little-red-rover/little-red-rover/README.md

# Little Red Rover

The Little Red Rover project has moved! Its new home is the [Little Red Rover GitHub organization](https://github.com/little-red-rover).
