little-red-rover/little-red-rover/HARDWARE/README.md

# HARDWARE

<p align="center">
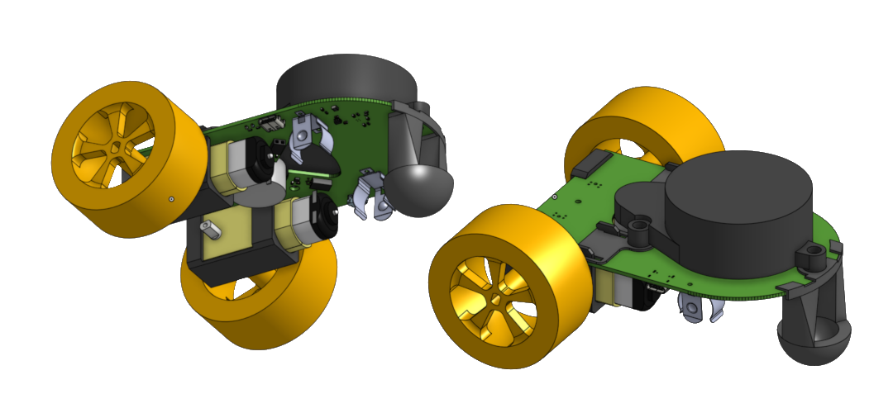
[picture p1: HARDWARE/assets/lrr_hardware_splash.png]
Splash image of LRR CAD
  
</p>

Little red rover was designed using OnShape and KiCAD (
[OnShape project](https://cad.onshape.com/documents/3c9bcb798eb55dc89c3300c0/w/50990f614f9cfbc3dc016690/e/81981a5257c68cf876fffafa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), [KiCAD project](https://github.com/usedhondacivic/little_red_rover/tree/main/HARDWARE/little_red_rover)
).

It is composed of:

* one PCB body
* five 3D printed components (one front skid, two motor mounts, two shims)
* two [TT motors](https://www.adafruit.com/product/3777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)
* two [wheels](https://www.adafruit.com/product/3766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)
* one [LD20 LiDAR](https://www.youyeetoo.com/products/youyeetoo-fhl-ld20)
* three M3 screws

and thats it!
