little-red-rover/little-red-rover/HARDWARE/assets/back_glam.jpg

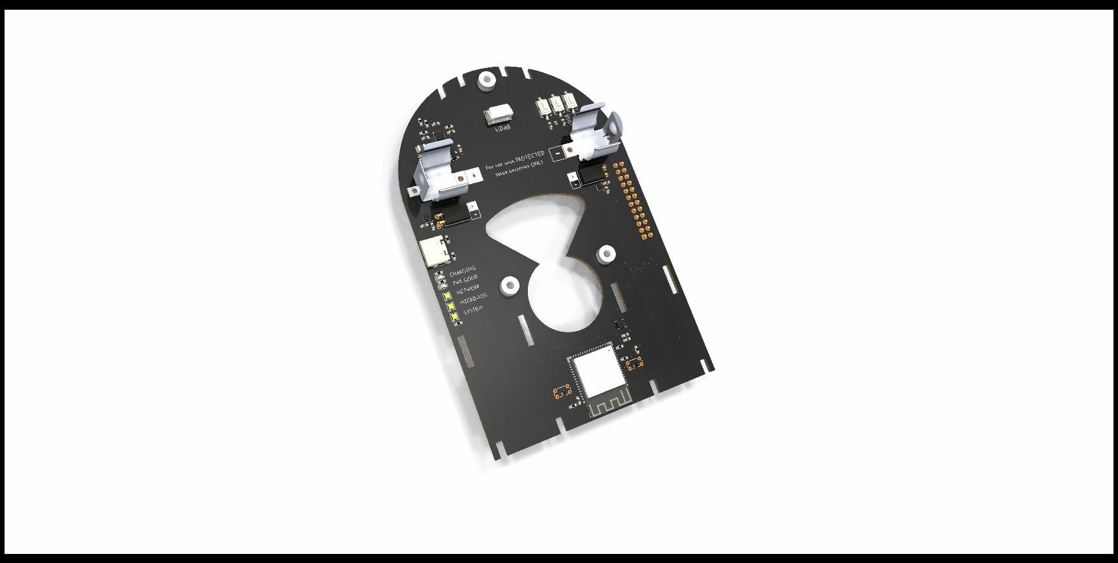
HARDWARE/assets/back_glam.jpg
