little-red-rover/little-red-rover/HARDWARE/assets/lrr_cad_bottom.png

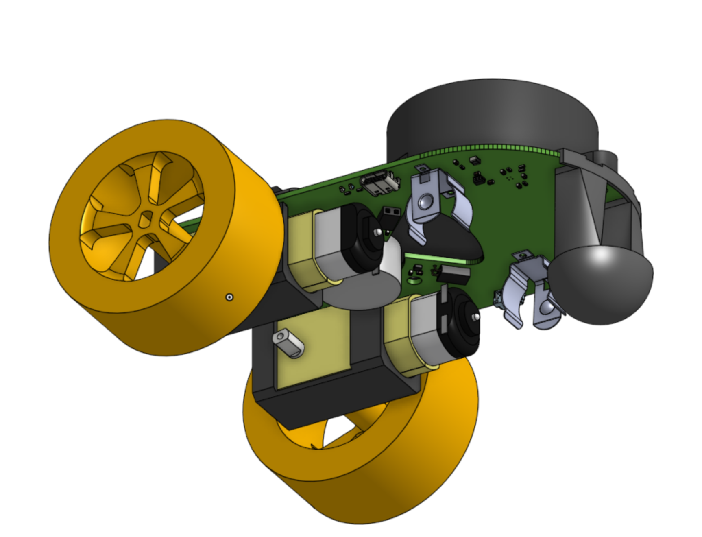
HARDWARE/assets/lrr_cad_bottom.png
