little-red-rover/little-red-rover/HARDWARE/assets/lrr_cad_top.png

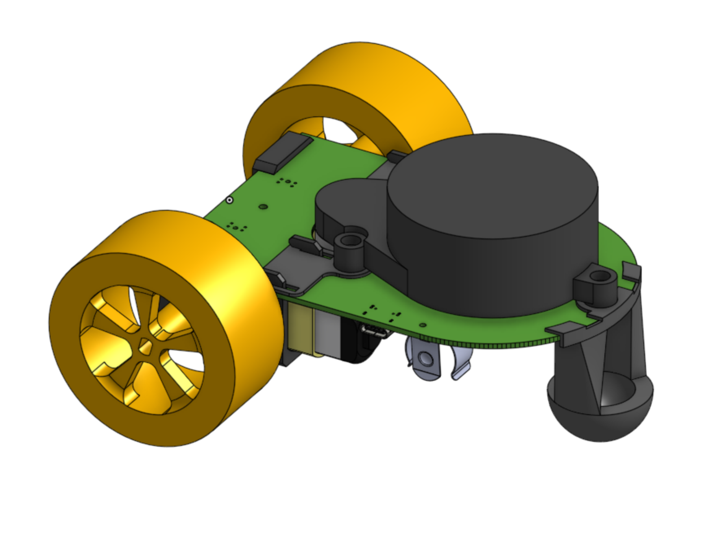
HARDWARE/assets/lrr_cad_top.png
