little-red-rover/little-red-rover/HARDWARE/assets/lrr_ecad.png

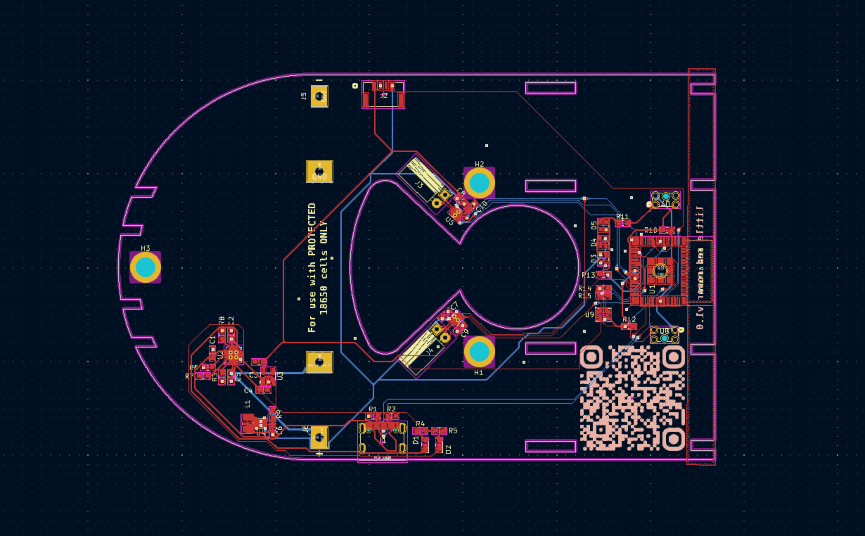
HARDWARE/assets/lrr_ecad.png
