little-red-rover/little-red-rover/SOFTWARE/ros2_ws/src/little_red_rover/description/rover/robot_body_visual.stl

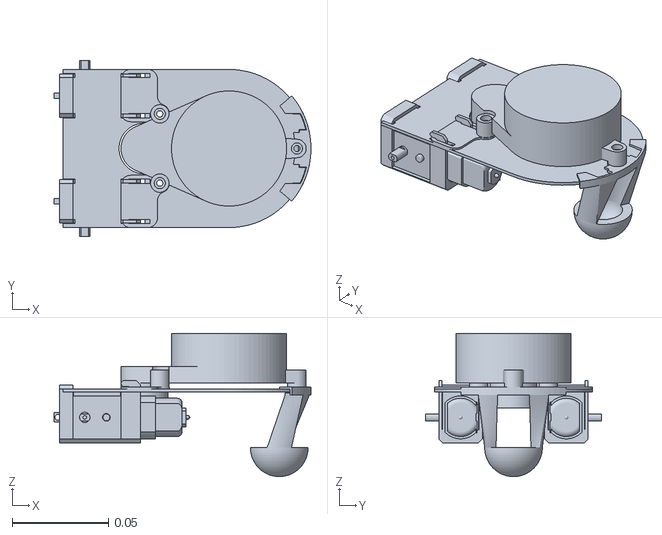
[picture p7: CAD file, 2024-08-25]
SOFTWARE/ros2_ws/src/little_red_rover/description/rover/robot_body_visual.stl
0.134 x 0.0916 x 0.0744
