little-red-rover/little-red-rover/SOFTWARE/ros2_ws/src/little_red_rover/description/rover/wheel_right_visual.stl

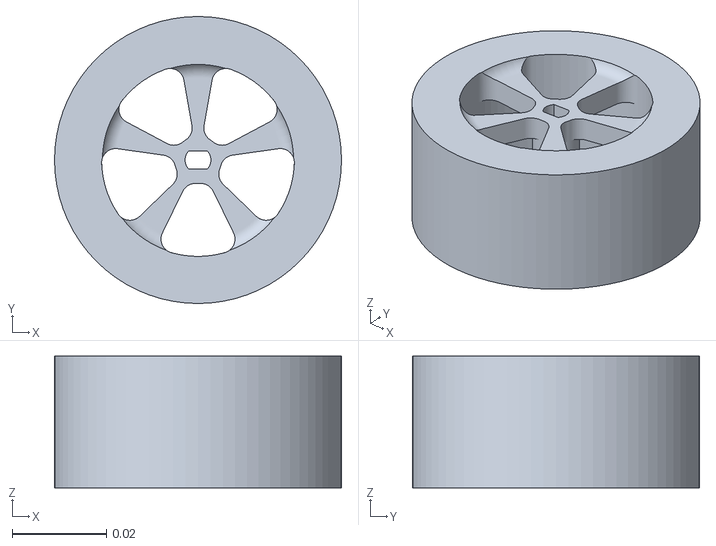
[picture p8: CAD file, 2024-08-25]
SOFTWARE/ros2_ws/src/little_red_rover/description/rover/wheel_right_visual.stl
0.061 x 0.061 x 0.0279
