little-red-rover/little-red-rover/SOFTWARE/ros2_ws/src/little_red_rover/description/rover/tt_motor_mount.stl

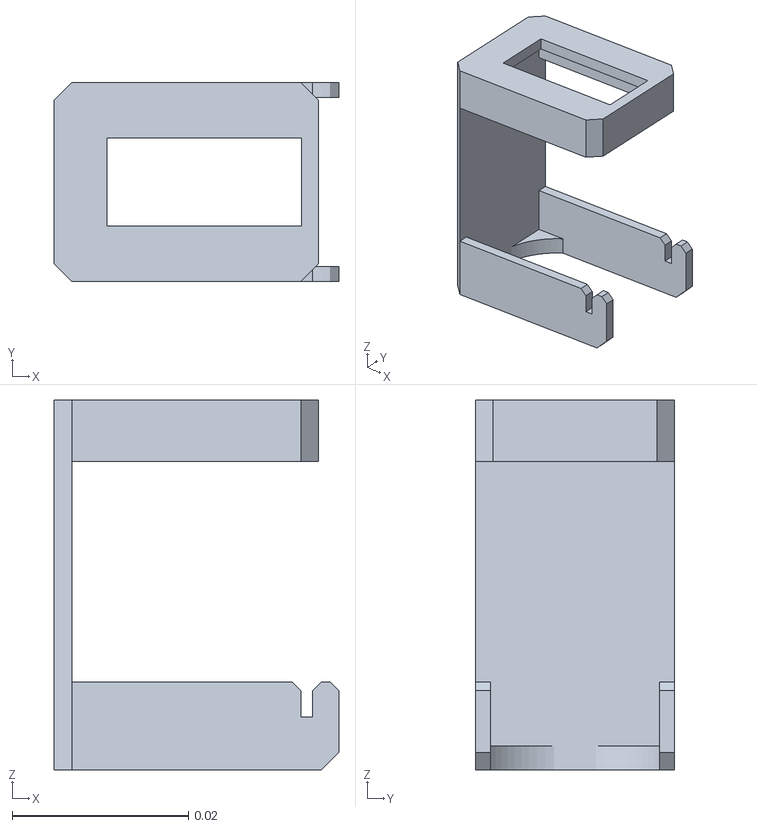
[picture p9: CAD file, 2024-08-04]
SOFTWARE/ros2_ws/src/little_red_rover/description/rover/tt_motor_mount.stl
0.0323 x 0.0226 x 0.042
