little-red-rover/little-red-rover/SOFTWARE/ros2_ws/src/little_red_rover/description/rover/motor_mount_shim.stl

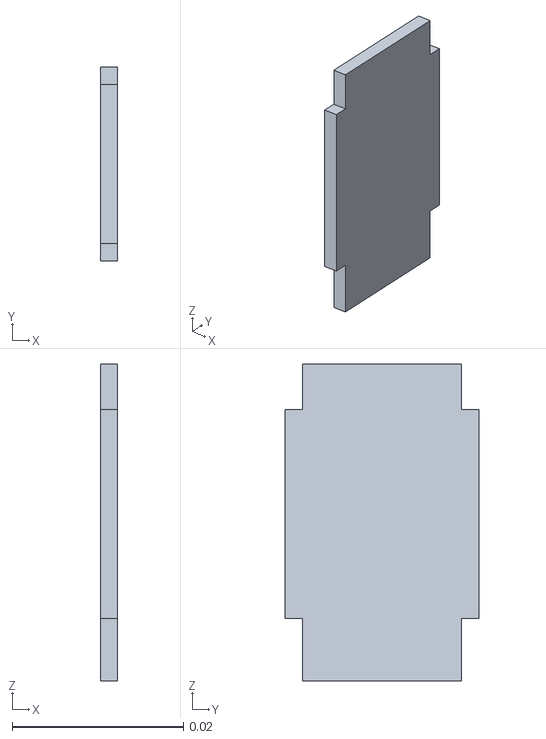
[picture p10: CAD file, 2024-08-04]
SOFTWARE/ros2_ws/src/little_red_rover/description/rover/motor_mount_shim.stl
0.002 x 0.0226 x 0.037
