little-red-rover/little-red-rover/SOFTWARE/ros2_ws/src/little_red_rover/description/rover/lidar_top.stl

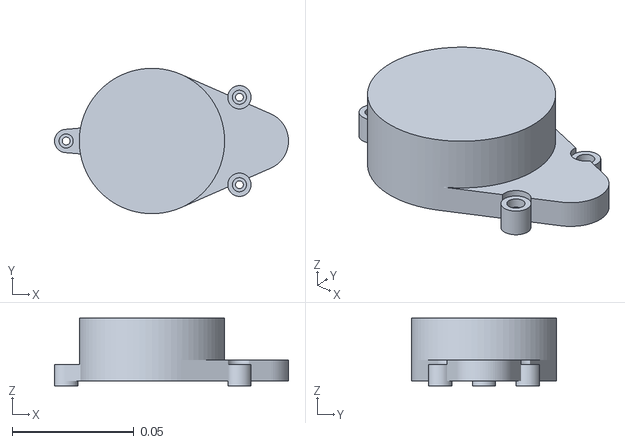
[picture p11: CAD file, 2024-08-04]
SOFTWARE/ros2_ws/src/little_red_rover/description/rover/lidar_top.stl
0.0963 x 0.0598 x 0.0279
