little-red-rover/little-red-rover/SOFTWARE/ros2_ws/src/little_red_rover/description/rover/motor_attachment_shim.stl

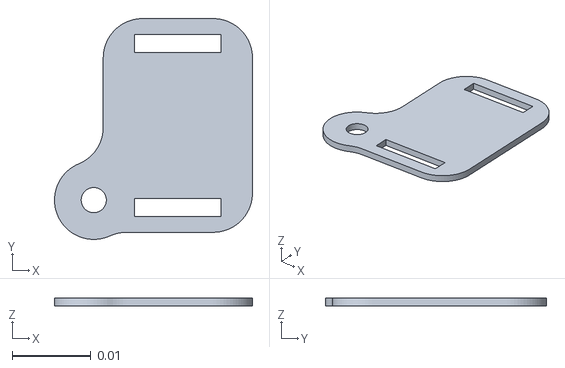
[picture p12: CAD file, 2024-08-04]
SOFTWARE/ros2_ws/src/little_red_rover/description/rover/motor_attachment_shim.stl
0.0252 x 0.0281 x 0.001
