little-red-rover/little-red-rover/SOFTWARE/ros2_ws/src/little_red_rover/description/rover/pcb.stl

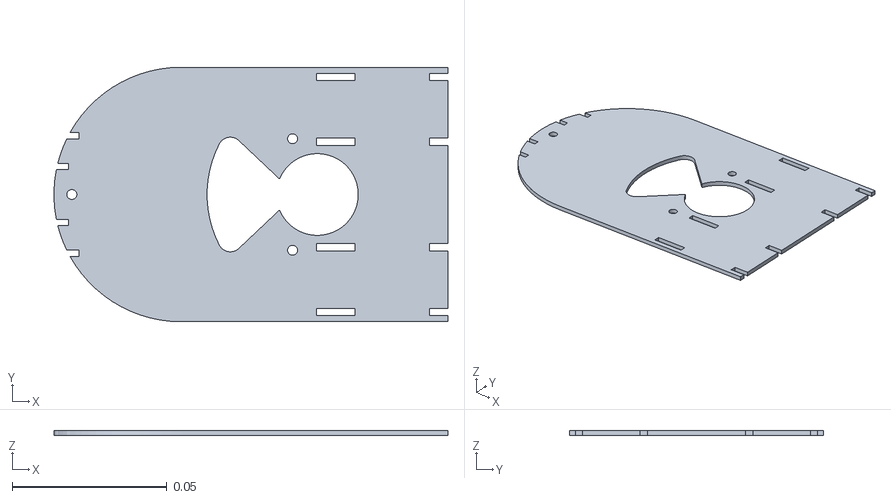
[picture p13: CAD file, 2024-08-04]
SOFTWARE/ros2_ws/src/little_red_rover/description/rover/pcb.stl
0.127 x 0.0822 x 0.0016
