little-red-rover/little-red-rover/SOFTWARE/ros2_ws/src/little_red_rover/description/rover/skid.stl

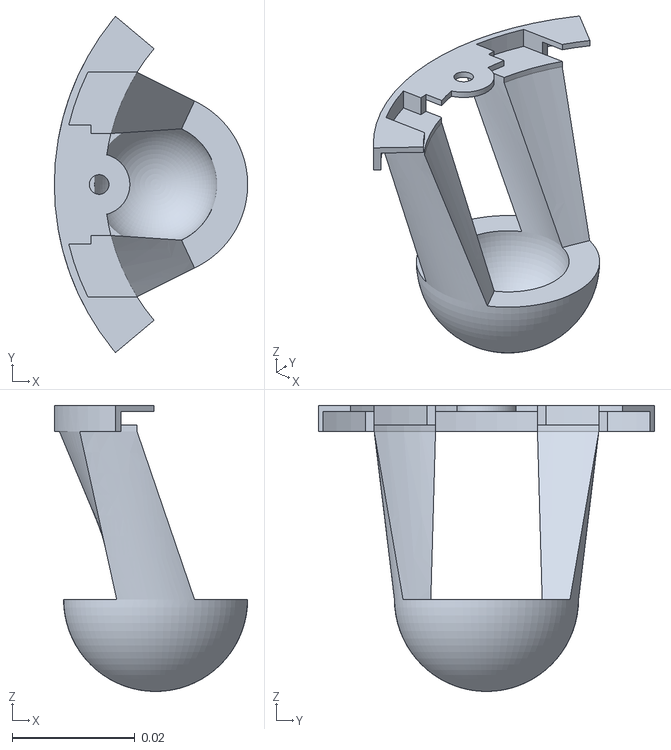
[picture p14: CAD file, 2024-08-04]
SOFTWARE/ros2_ws/src/little_red_rover/description/rover/skid.stl
0.0315 x 0.0548 x 0.0466
