little-red-rover/little-red-rover/SOFTWARE/ros2_ws/src/little_red_rover/description/rover/lidar_motor.stl

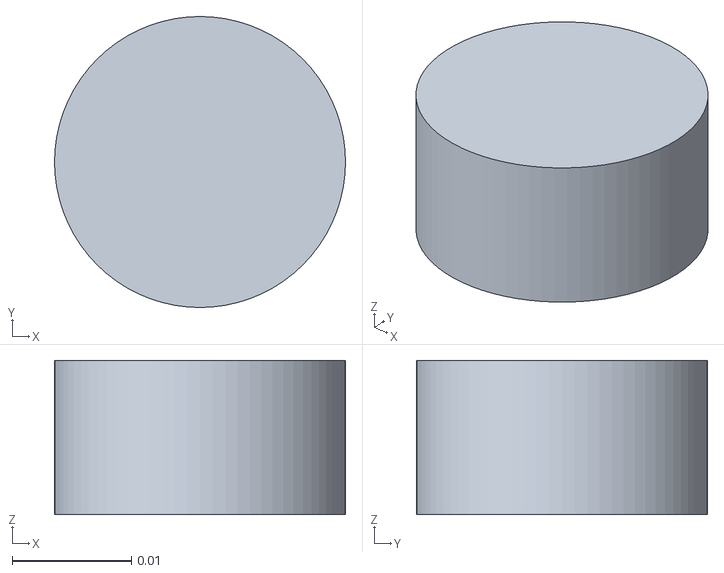
[picture p15: CAD file, 2024-08-04]
SOFTWARE/ros2_ws/src/little_red_rover/description/rover/lidar_motor.stl
0.0244 x 0.0244 x 0.0129
