little-red-rover/little-red-rover/SOFTWARE/ros2_ws/src/little_red_rover/description/rover/coordinate_frame.stl

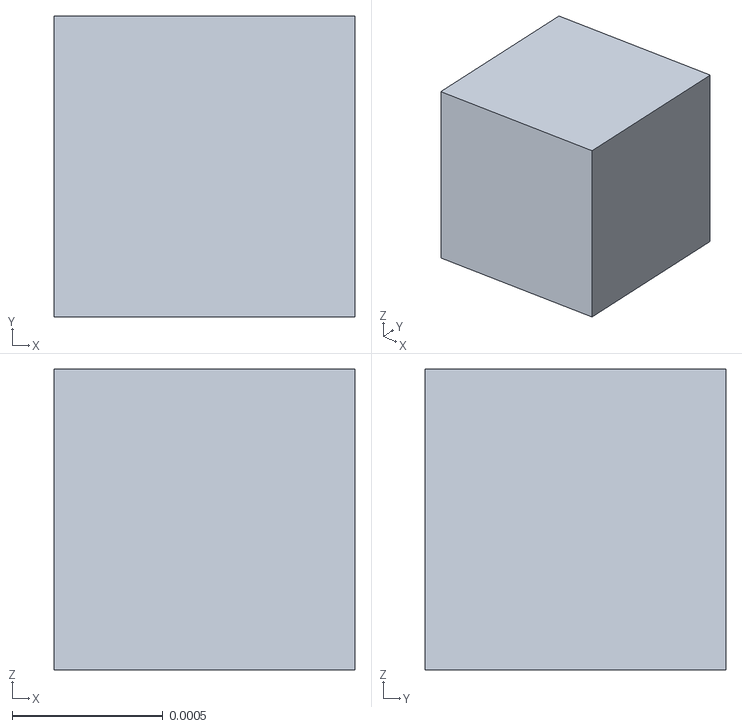
[picture p16: CAD file, 2024-07-20]
SOFTWARE/ros2_ws/src/little_red_rover/description/rover/coordinate_frame.stl
0.001 x 0.001 x 0.001
