little-red-rover/little-red-rover/SOFTWARE/ros2_ws/src/little_red_rover/description/rover/encoder_ring.stl

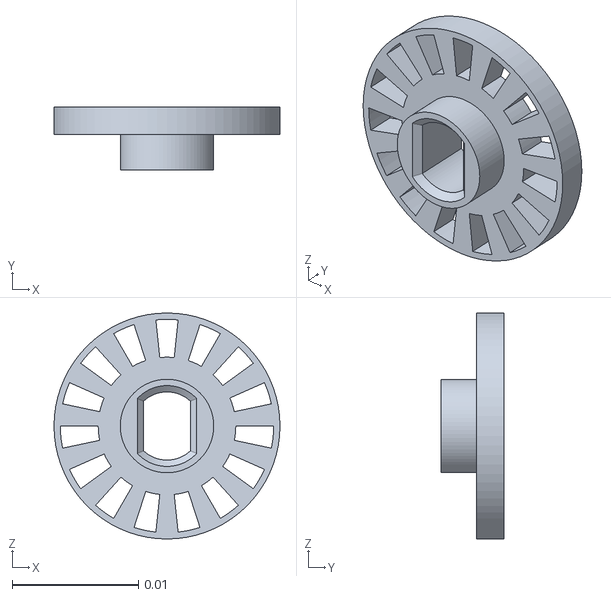
[picture p17: CAD file, 2024-07-16]
SOFTWARE/ros2_ws/src/little_red_rover/description/rover/encoder_ring.stl
0.0179 x 0.005 x 0.0179
