little-red-rover/little-red-rover/SOFTWARE/ros2_ws/src/little_red_rover/description/rover/tt_motor_mount_right.stl

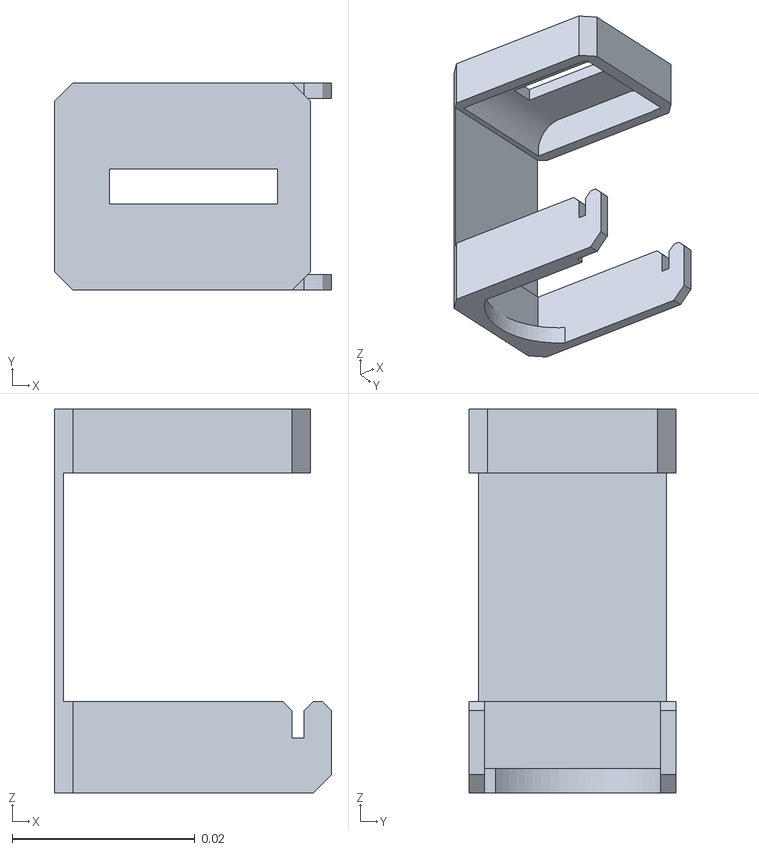
[picture p18: CAD file, 2024-05-02]
SOFTWARE/ros2_ws/src/little_red_rover/description/rover/tt_motor_mount_right.stl
0.0303 x 0.0226 x 0.042
