little-red-rover/little-red-rover/SOFTWARE/ros2_ws/src/little_red_rover/description/rover/tt_motor_3777_v10.stl

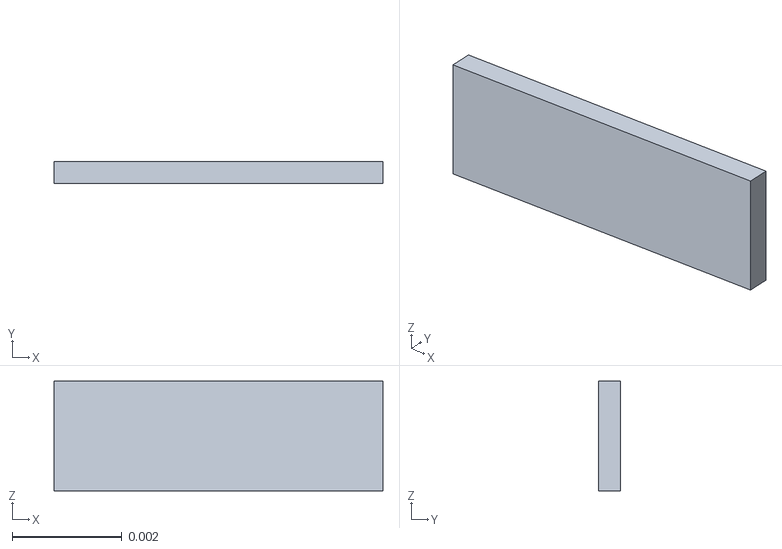
[picture p19: CAD file, 2024-05-02]
SOFTWARE/ros2_ws/src/little_red_rover/description/rover/tt_motor_3777_v10.stl
0.006 x 0.0004 x 0.002
