little-red-rover/little-red-rover/(list of files, cad)

Other CAD files:
SOFTWARE/ros2_ws/src/little_red_rover/description/rover/wheel_left_visual.stl
SOFTWARE/ros2_ws/src/little_red_rover/description/rover/wheel_right.stl
SOFTWARE/ros2_ws/src/little_red_rover/description/rover/wheel_2_visual.stl
SOFTWARE/ros2_ws/src/little_red_rover/description/rover/wheel_visual.stl
SOFTWARE/ros2_ws/src/little_red_rover/description/rover/wheel_left.stl
SOFTWARE/ros2_ws/src/little_red_rover/description/rover/tt_motor_mount_left.stl
SOFTWARE/ros2_ws/src/little_red_rover/description/rover/wheel.stl
