little-red-rover/little-red-rover/HARDWARE/little_red_rover/little_red_rover.kicad_pcb

## KiCad design HARDWARE/little_red_rover/little_red_rover.kicad_pcb (2024-06-24)

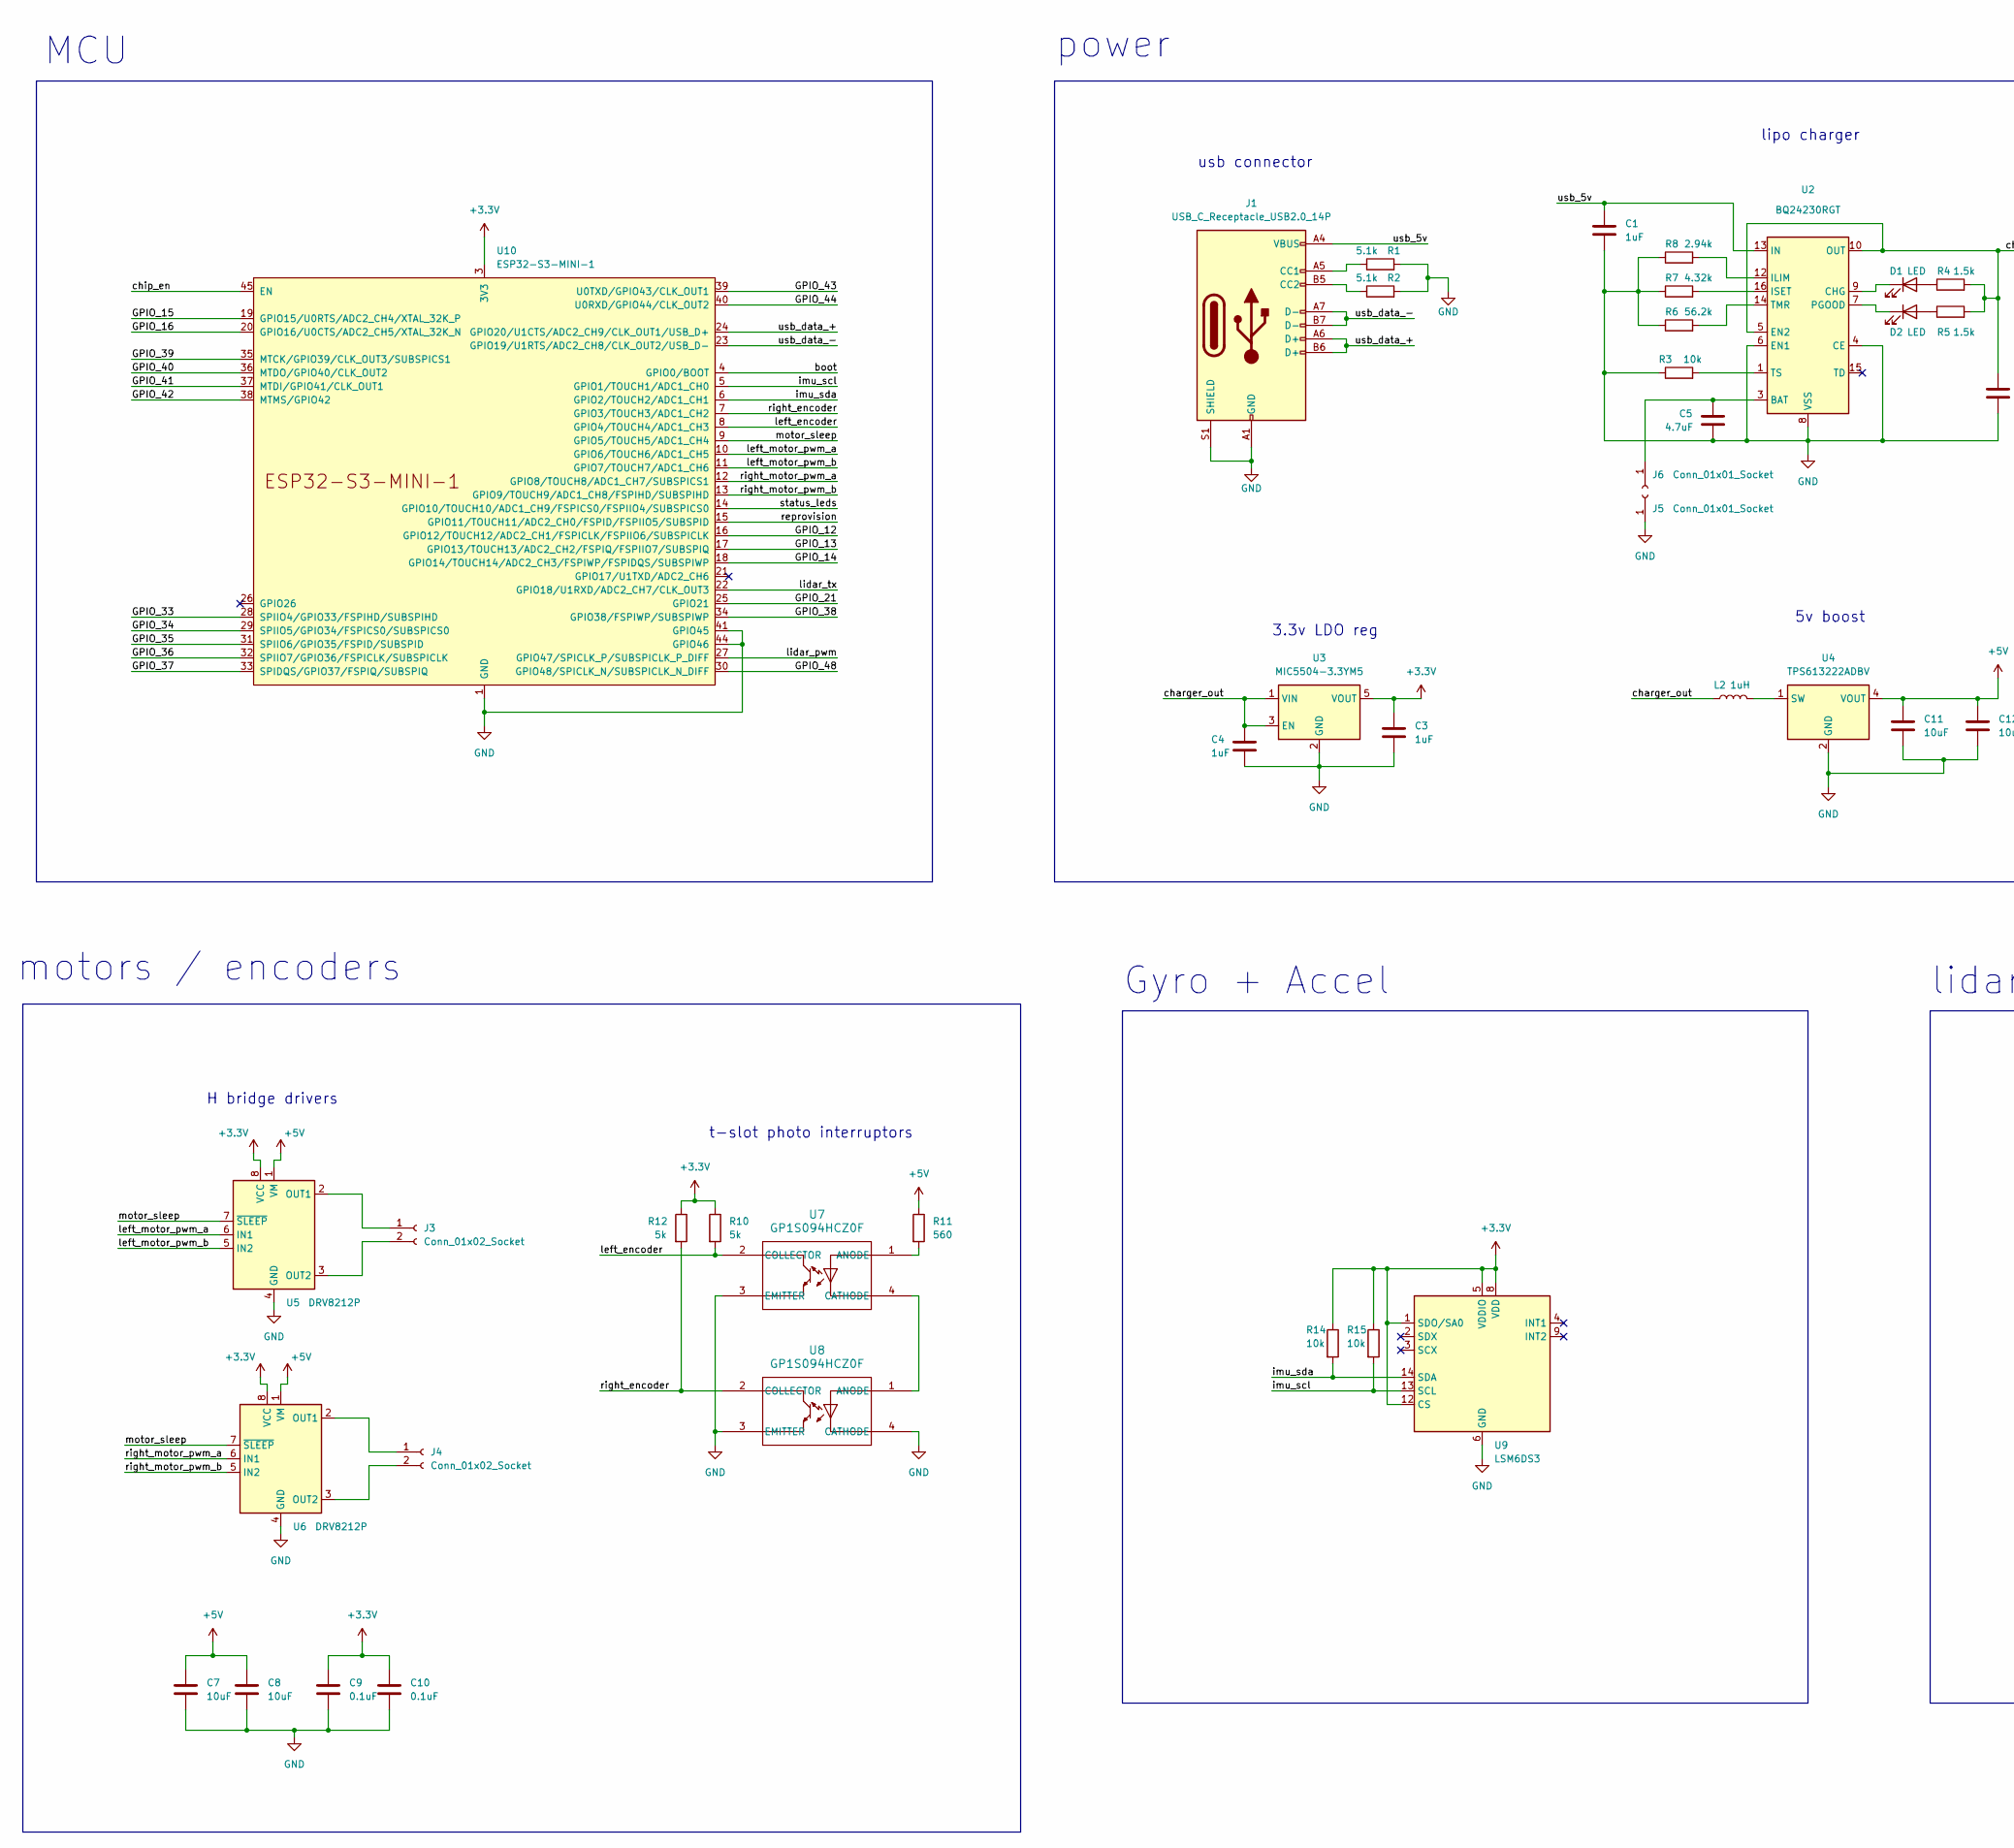
[picture p20: schematic little_red_rover.kicad_sch, Little Red Rover, part in row 1, column 1]

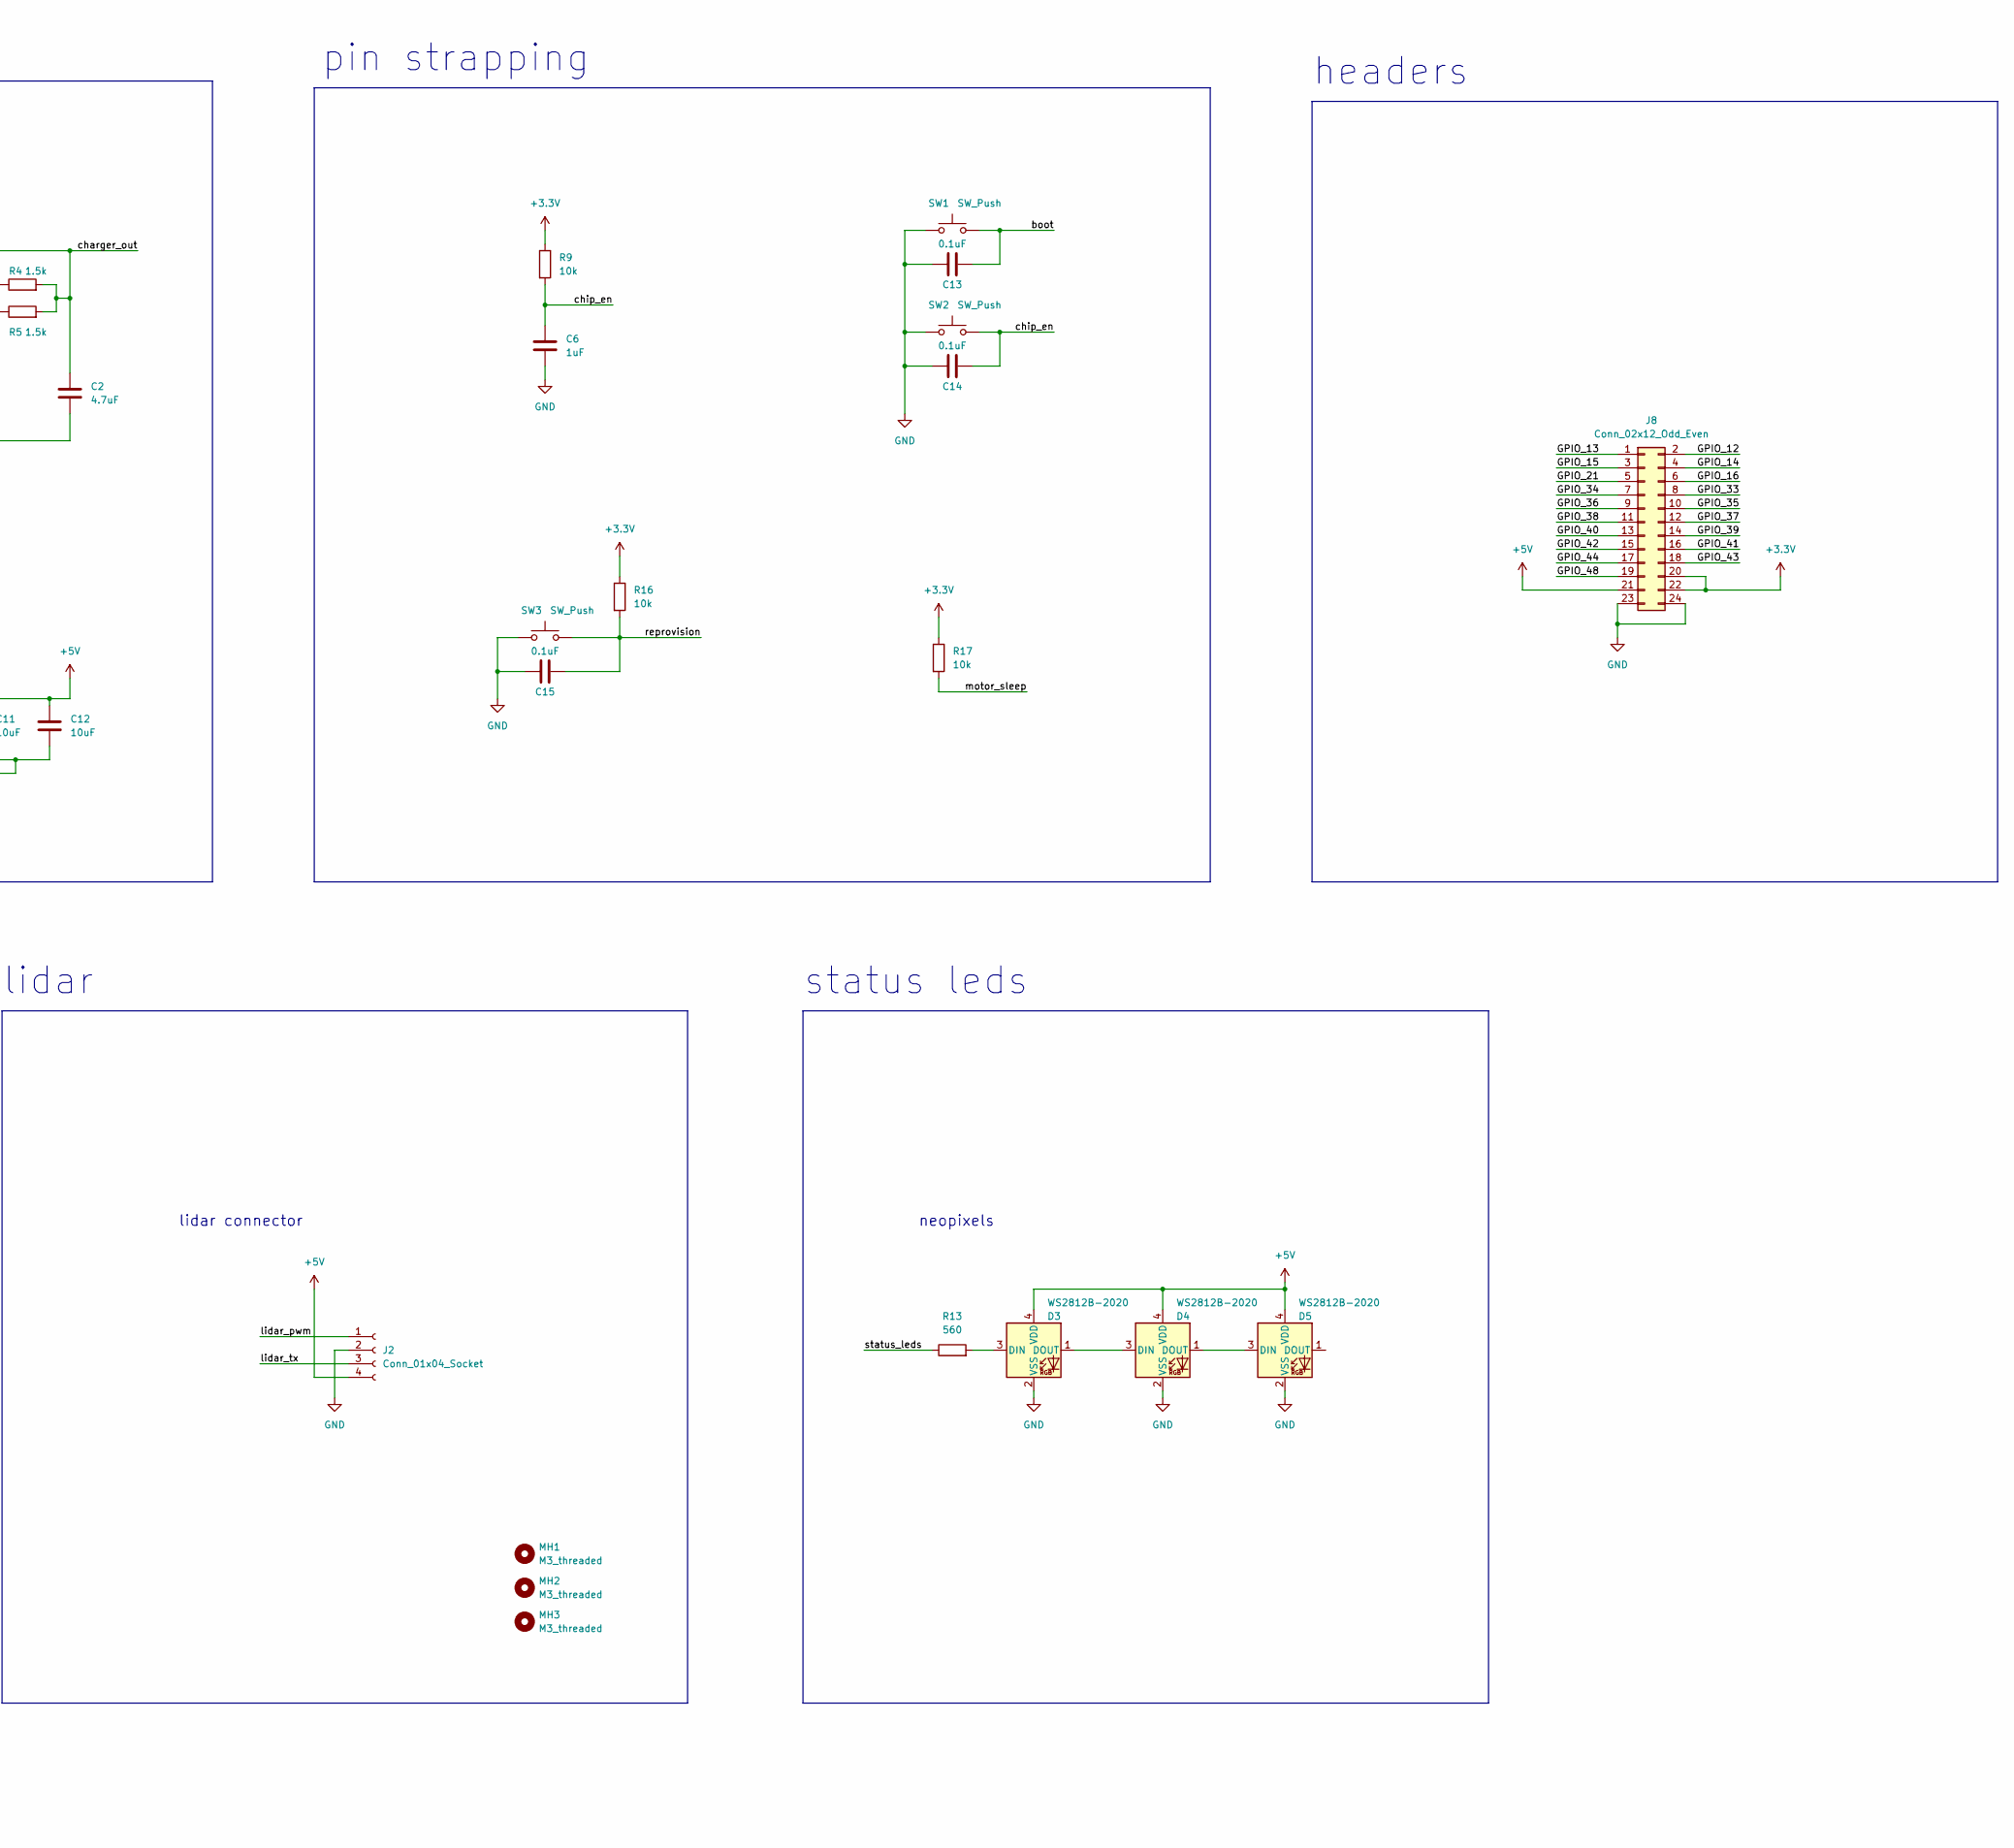
[picture p21: schematic little_red_rover.kicad_sch, Little Red Rover, part in row 1, column 2]

Parts:
C1, C3, C4: 1uF; C_0603_1608Metric_Pad1.08x0.95mm_HandSolder; JLC 0603
C2, C5: 4.7uF; C_0603_1608Metric_Pad1.08x0.95mm_HandSolder; JLC 0603
C6: 1uF; C_0603_1608Metric_Pad1.08x0.95mm_HandSolder
C7, C8, C11, C12: 10uF; C_0603_1608Metric_Pad1.08x0.95mm_HandSolder; JLC 0603
C9, C10: 0.1uF; C_0603_1608Metric_Pad1.08x0.95mm_HandSolder; JLC 0603
C13, C14, C15: 0.1uF; C_0603_1608Metric_Pad1.08x0.95mm_HandSolder
D1, D2: LED; LED_0603_1608Metric_Pad1.05x0.95mm_HandSolder; JLC 0603
D3, D4, D5: WS2812B-2020; LED_WS2812B-2020_PLCC4_2.0x2.0mm; JLC SMD,2x2mm
J1: USB_C_Receptacle_USB2.0_14P; USB_C_Receptacle_GCT_USB4105-xx-A_16P_TopMnt_Horizontal; JLC SMD
J2: Conn_01x04_Socket; CONN_SM04B-GHS-TB_JST; JLC SMD,P=1.25mm
J3, J4: Conn_01x02_Socket; PinSocket_1x02_P2.54mm_Horizontal; JLC Push-Pull,P=2.54mm
J5, J6: Conn_01x01_Socket; 18650_holder; JLC SMD
J8: Conn_02x12_Odd_Even; PinHeader_2x12_P2.54mm_Vertical
L2: 1uH; L_1008_2520Metric_Pad1.43x2.20mm_HandSolder; JLC 1008
MH1, MH2, MH3: M3_threaded; m3_threaded_insert; LCSC C5301780
R1, R2: 5.1k; R_0603_1608Metric_Pad0.98x0.95mm_HandSolder; JLC 0603
R3: 10k; R_0603_1608Metric_Pad0.98x0.95mm_HandSolder; JLC 0603
R4, R5: 1.5k; R_0603_1608Metric_Pad0.98x0.95mm_HandSolder; JLC 0603
R6: 56.2k; R_0603_1608Metric_Pad0.98x0.95mm_HandSolder; JLC 0603
R7: 4.32k; R_0603_1608Metric_Pad0.98x0.95mm_HandSolder; JLC 0603
R8: 2.94k; R_0603_1608Metric_Pad0.98x0.95mm_HandSolder; JLC 0603
R9, R16, R17: 10k; R_0603_1608Metric_Pad0.98x0.95mm_HandSolder
R10, R12: 5k; R_0603_1608Metric_Pad0.98x0.95mm_HandSolder; JLC 0603
R11, R13: 560; R_0603_1608Metric_Pad0.98x0.95mm_HandSolder; JLC 0603
R14, R15: 10k; C_0603_1608Metric_Pad1.08x0.95mm_HandSolder; JLC 0603
SW1, SW2, SW3: SW_Push; SW_Tactile_SPST_NO_Straight_CK_PTS636Sx25SMTRLFS
U2: BQ24230RGT; VQFN-16-1EP_3x3mm_P0.5mm_EP1.68x1.68mm_ThermalVias; JLC VQFN-16-EP(3x3)
U3: MIC5504-3.3YM5; SOT-23-5; JLC SOT-23-5
U4: TPS613222ADBV; SOT-23-5; JLC SOT-23-5
U5, U6: DRV8212P; WSON-8-1EP_2x2mm_P0.5mm_EP0.9x1.6mm_ThermalVias; JLC WSON-8(2x2)
U7, U8: GP1S094HCZ0F; TO_4HCZ0F_SHP; JLC DIP-4
U9: LSM6DS3; LGA-14_3x2.5mm_P0.5mm_LayoutBorder3x4y; JLC LGA-14(2.5x3)
U10: ESP32-S3-MINI-1; ESP32-S2-MINI-1_HandSoldering

Connections:
+3.3V: C3.1, C9.1, C10.1, J8.20, J8.22, R9.1, R10.1, R12.1, R14.1, R15.1, R16.1, R17.1, U3.5 (VOUT), U5.8 (VCC), U6.8 (VCC), U9.1 (SDO/SA0), U9.5 (VDDIO), U9.8 (VDD), U9.12 (CS), U10.3 (3V3)
+5V: C7.1, C8.1, C11.1, C12.1, D3.4 (VDD), D4.4 (VDD), D5.4 (VDD), J2.4, J8.21, R11.1, U4.4 (VOUT), U5.1 (VM), U6.1 (VM)
/GPIO_12: J8.2, U10.16 (GPIO12/TOUCH12/ADC2_CH1/FSPICLK/FSPIIO6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)
/GPIO_13: J8.1, U10.17 (GPIO13/TOUCH13/ADC2_CH2/FSPIQ/FSPIIO7/S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)
/GPIO_14: J8.4, U10.18 (GPIO14/TOUCH14/ADC2_CH3/FSPIWP/FSPIDQS/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)
/GPIO_15: J8.3, U10.19 (GPIO15/U0RTS/ADC2_CH4/XTAL_32K_P)
/GPIO_16: J8.6, U10.20 (GPIO16/U0CTS/ADC2_CH5/XTAL_32K_N)
/GPIO_21: J8.5, U10.25 (GPIO21)
/GPIO_33: J8.8, U10.28 (SPIIO4/GPIO33/FSPIHD/SUBSPIHD)
/GPIO_34: J8.7, U10.29 (SPIIO5/GPIO34/FSPICS0/SUBSPICS0)
/GPIO_35: J8.10, U10.31 (SPIIO6/GPIO35/FSPID/SUBSPID)
/GPIO_36: J8.9, U10.32 (SPIIO7/GPIO36/FSPICLK/SUBSPICLK)
/GPIO_37: J8.12, U10.33 (SPIDQS/GPIO37/FSPIQ/SUBSPIQ)
/GPIO_38: J8.11, U10.34 (GPIO38/FSPIWP/SUBSPIWP)
/GPIO_39: J8.14, U10.35 (MTCK/GPIO39/CLK_OUT3/SUBSPICS1)
/GPIO_40: J8.13, U10.36 (MTDO/GPIO40/CLK_OUT2)
/GPIO_41: J8.16, U10.37 (MTDI/GPIO41/CLK_OUT1)
/GPIO_42: J8.15, U10.38 (MTMS/GPIO42)
/GPIO_43: J8.18, U10.39 (U0TXD/GPIO43/CLK_OUT1)
/GPIO_44: J8.17, U10.40 (U0RXD/GPIO44/CLK_OUT2)
/GPIO_48: J8.19, U10.30 (GPIO48/SPICLK_N/SUBSPICLK_N_DIFF)
/boot: C13.2, SW1.2, U10.4 (GPIO0/BOOT)
/charger_out: C2.1, C4.1, L2.1, R4.2, R5.2, U2.5 (EN2), U2.10 (OUT), U2.11 (OUT), U3.1 (VIN), U3.3 (EN)
/chip_en: C6.1, C14.2, R9.2, SW2.2, U10.45 (EN)
/imu_scl: R15.2, U9.13 (SCL), U10.5 (GPIO1/TOUCH1/ADC1_CH0)
/imu_sda: R14.2, U9.14 (SDA), U10.6 (GPIO2/TOUCH2/ADC1_CH1)
/left_encoder: R10.2, U7.2 (COLLECTOR), U10.8 (GPIO4/TOUCH4/ADC1_CH3)
/left_motor_pwm_a: U5.6 (IN1), U10.10 (GPIO6/TOUCH6/ADC1_CH5)
/left_motor_pwm_b: U5.5 (IN2), U10.11 (GPIO7/TOUCH7/ADC1_CH6)
/lidar_pwm: J2.1, U10.27 (GPIO47/SPICLK_P/SUBSPICLK_P_DIFF)
/lidar_tx: J2.3, U10.22 (GPIO18/U1RXD/ADC2_CH7/CLK_OUT3)
/motor_sleep: R17.2, U5.7 (~SLEEP), U6.7 (~SLEEP), U10.9 (GPIO5/TOUCH5/ADC1_CH4)
/reprovision: C15.2, R16.2, SW3.2, U10.15 (GPIO11/TOUCH11/ADC2_CH0/FSPID/FSPIIO5/S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)
/right_encoder: R12.2, U8.2 (COLLECTOR), U10.7 (GPIO3/TOUCH3/ADC1_CH2)
/right_motor_pwm_a: U6.6 (IN1), U10.12 (GPIO8/TOUCH8/ADC1_CH7/SUBSPICS1)
/right_motor_pwm_b: U6.5 (IN2), U10.13 (GPIO9/TOUCH9/ADC1_CH8/FSPIHD/SUBSPIHD)
/status_leds: R13.1, U10.14 (GPIO10/TOUCH10/ADC1_CH9/FSPICS0/FSPIIO4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)
/usb_5v: C1.1, J1.A4 (VBUS), J1.A9 (VBUS), J1.B4 (VBUS), J1.B9 (VBUS), U2.13 (IN)
/usb_data_+: J1.A6 (D+), J1.B6 (D+), U10.24 (GPIO20/U1CTS/ADC2_CH9/CLK_OUT1/USB_D+)
/usb_data_-: J1.A7 (D-), J1.B7 (D-), U10.23 (GPIO19/U1RTS/ADC2_CH8/CLK_OUT2/USB_D-)
GND: C1.2, C2.2, C3.2, C4.2, C5.2, C6.2, C7.2, C8.2, C9.2, C10.2, C11.2, C12.2, C13.1, C14.1, C15.1, D3.2 (VSS), D4.2 (VSS), D5.2 (VSS), J1.A1 (GND), J1.A12 (GND), J1.B1 (GND), J1.B12 (GND), J1.S1 (SHIELD), J2.2, J5.1, J8.23, J8.24, R1.2, R2.2, R3.1, R6.1, R7.1, R8.1, SW1.1, SW2.1, SW3.1, U2.4 (CE), U2.6 (EN1), U2.8 (VSS), U2.17 (VSS), U3.2 (GND), U4.2 (GND), U5.4 (GND), U5.9 (GND), U6.4 (GND), U6.9 (GND), U7.3 (EMITTER), U8.3 (EMITTER), U8.4 (CATHODE), U9.6 (GND), U9.7 (GND), U10.1 (GND), U10.2 (GND), U10.41 (GPIO45), U10.42 (GND), U10.43 (GND), U10.44 (GPIO46), U10.46 (GND), U10.47 (GND), U10.48 (GND), U10.49 (GND), U10.50 (GND), U10.51 (GND), U10.52 (GND), U10.53 (GND), U10.54 (GND), U10.55 (GND), U10.56 (GND), U10.57 (GND), U10.58 (GND), U10.59 (GND), U10.60 (GND), U10.61 (GND), U10.62 (GND), U10.63 (GND), U10.64 (GND), U10.65 (GND)
unnamed: D1.2 (A), R4.1
unnamed: D1.1 (K), U2.9 (CHG)
unnamed: D2.2 (A), R5.1
unnamed: D2.1 (K), U2.7 (PGOOD)
unnamed: D3.3 (DIN), R13.2
unnamed: D3.1 (DOUT), D4.3 (DIN)
unnamed: D4.1 (DOUT), D5.3 (DIN)
unnamed: J1.A5 (CC1), R1.1
unnamed: J1.B5 (CC2), R2.1
unnamed: J3.1, U5.2 (OUT1)
unnamed: J3.2, U5.3 (OUT2)
unnamed: J4.1, U6.2 (OUT1)
unnamed: J4.2, U6.3 (OUT2)
unnamed: C5.1, J6.1, U2.2 (BAT), U2.3 (BAT)
unnamed: R8.2, U2.12 (ILIM)
unnamed: R7.2, U2.16 (ISET)
unnamed: R6.2, U2.14 (TMR)
unnamed: R3.2, U2.1 (TS)
unnamed: L2.2, U4.1 (SW)
unnamed: R11.2, U7.1 (ANODE)
unnamed: U7.4 (CATHODE), U8.1 (ANODE)

Notes on the sheet:
pin strapping
lidar
3.3v LDO reg
neopixels
lidar connector
H bridge drivers
power
lipo charger
t-slot photo interruptors
usb connector
status leds
headers
MCU
Gyro + Accel
5v boost
motors / encoders

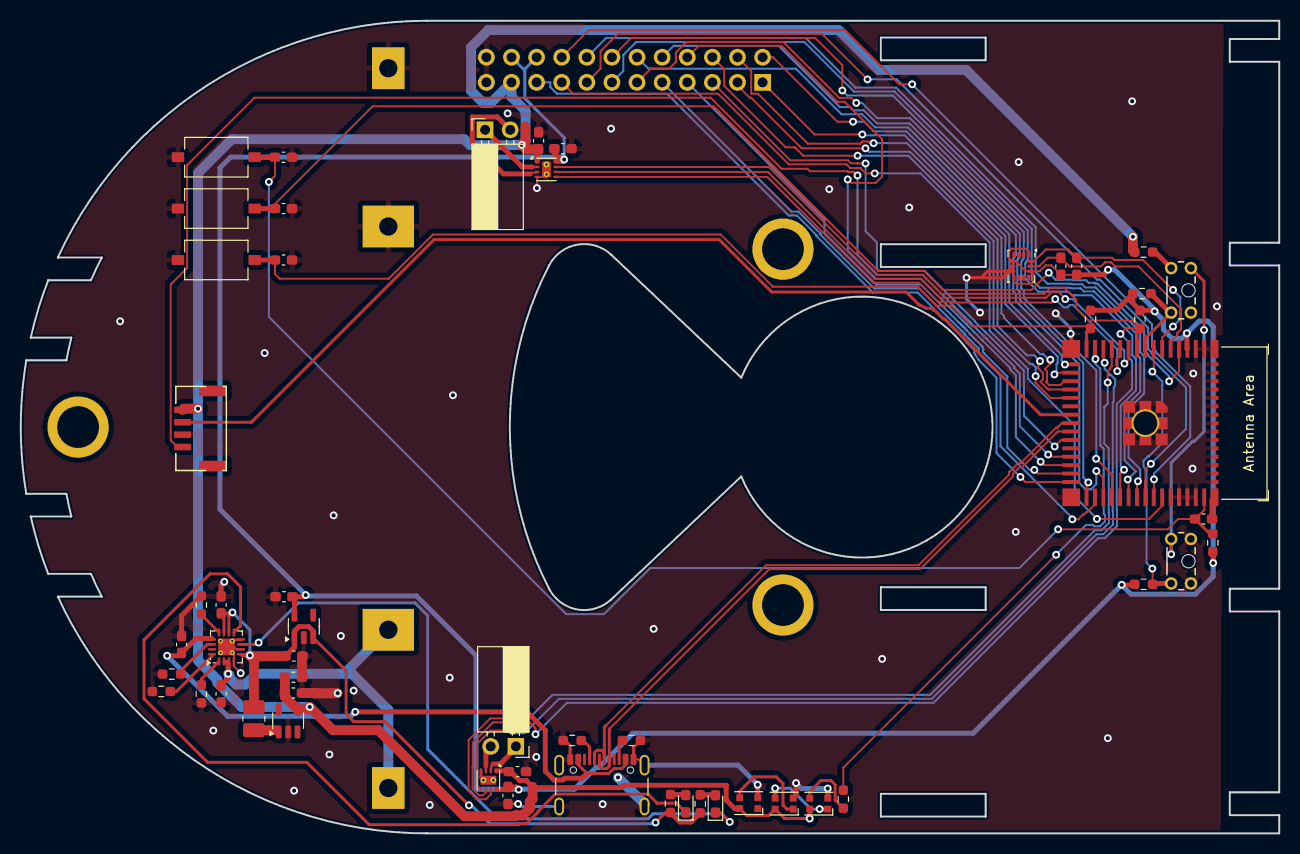
[picture p22: board little_red_rover.kicad_pcb from above]

Board: 2 copper layers, 127.3 x 82.2 mm, 60 parts (1 on the bottom side), 62 nets.
