little-red-rover/little-red-rover/SOFTWARE/esp32_firmware/components/drive_base_driver/motor_driver.c

/*
 * Motor control rountines for LRR.
 * Closed loop velocity control for TT Motors with an encoder.
 *
 * References
 *
 * PWM:
 * https://github.com/espressif/esp-idf/blob/master/examples/peripherals/ledc/ledc_basic/main/ledc_basic_example_main.c
 *
 * PID CONTROL:
 * https://github.com/espressif/esp-idf/blob/master/examples/peripherals/mcpwm/mcpwm_bdc_speed_control/main/mcpwm_bdc_control_example_main.c
 *
 * PULSE COUNTER:
 * https://github.com/espressif/esp-idf/blob/master/examples/peripherals/pcnt/rotary_encoder/main/rotary_encoder_example_main.c
 */

#include "motor_driver.h"

#include "freertos/FreeRTOS.h"
#include "freertos/task.h"

#include "driver/gpio.h"
#include "driver/ledc.h"
#include "driver/pulse_cnt.h"
#include "esp_timer.h"
#include "hal/gpio_types.h"
#include "hal/pcnt_types.h"
#include "pid_ctrl.h"

#include <math.h>
#include <stdlib.h>

#define PWM_TIMER_RESOLUTION LEDC_TIMER_10_BIT

// Anything above audible is fine
#define PWM_FREQ_HZ 25000

// Max change to motor power per pid cycle
// Reduces current surges
#define MAX_JERK 0.1

// Minimum % duty that must be applied to affect any motion
// Inputs below this level are ignored
#define HYSTERESIS 0.25

#define PID_LOOP_PERIOD_MS 10.0

#define PULSES_PER_ROTATION 2340.0
#define PULSES_TO_RAD(pulses)                                                  \
    (((float)pulses / PULSES_PER_ROTATION) * (2 * M_PI))

double clamp(float d, float min, float max)
{
    const float t = d < min ? min : d;
    return t > max ? max : t;
}

double mod(double a, double b)
{
    return a - ((int)(a / b)) * b;
}

void set_motor_enabled(motor_handle_t *motor, bool enable)
{
    gpio_set_direction(motor->enable_pin, GPIO_MODE_OUTPUT);

    if (enable) {
        gpio_set_level(motor->enable_pin, 1);
    } else {
        gpio_set_level(motor->enable_pin, 0);
    }
}

static void set_motor_power(motor_handle_t *motor, float power)
{
    power = clamp(power, -1.0, 1.0);
    if (power > HYSTERESIS) {
        ledc_set_duty(LEDC_LOW_SPEED_MODE,
                      motor->chan_b,
                      (uint32_t)(power * (float)(1 << PWM_TIMER_RESOLUTION)));
        ledc_set_duty(LEDC_LOW_SPEED_MODE, motor->chan_a, 0);
    } else if (power < HYSTERESIS) {
        ledc_set_duty(LEDC_LOW_SPEED_MODE, motor->chan_b, 0);
        ledc_set_duty(LEDC_LOW_SPEED_MODE,
                      motor->chan_a,
                      (uint32_t)(-power * (float)(1 << PWM_TIMER_RESOLUTION)));
    } else {
        ledc_set_duty(LEDC_LOW_SPEED_MODE, motor->chan_b, 0);
        ledc_set_duty(LEDC_LOW_SPEED_MODE, motor->chan_a, 0);
    }

    ledc_update_duty(LEDC_LOW_SPEED_MODE, motor->chan_a);
    ledc_update_duty(LEDC_LOW_SPEED_MODE, motor->chan_b);
}

void set_motor_velocity(motor_handle_t *motor, float velocity)
{
    if (motor->reversed) {
        velocity *= -1;
    }
    motor->cmd_velocity = velocity;
}

void configure_pwm(ledc_channel_t channel, int gpio)
{
    ledc_channel_config_t pwm_channel = { .speed_mode = LEDC_LOW_SPEED_MODE,
                                          .channel = channel,
                                          .timer_sel = LEDC_TIMER_0,
                                          .intr_type = LEDC_INTR_DISABLE,
                                          .gpio_num = gpio,
                                          .duty = 0,
                                          .hpoint = 0 };

    ESP_ERROR_CHECK(ledc_channel_config(&pwm_channel));
}

void pid_callback(void *arg)
{
    motor_handle_t *motor = (motor_handle_t *)arg;

    int current_encoder_count;
    pcnt_unit_get_count(motor->encoder.unit, &current_encoder_count);
    int pulses_elapsed = current_encoder_count - motor->encoder.count;
    motor->encoder.velocity =
      PULSES_TO_RAD(pulses_elapsed) * (1000.0 / PID_LOOP_PERIOD_MS);
    motor->encoder.position = PULSES_TO_RAD(current_encoder_count);
    double error = motor->cmd_velocity - motor->encoder.velocity;

    ESP_ERROR_CHECK(
      pid_compute(motor->pid_controller, error, &motor->cmd_effort));

    motor->applied_effort = clamp(motor->cmd_effort,
                                  motor->applied_effort - MAX_JERK,
                                  motor->applied_effort + MAX_JERK);

    set_motor_power(motor, motor->applied_effort);

    motor->encoder.count = current_encoder_count;
};

void configure_motor(motor_handle_t *motor,
                     char *motor_name,
                     gpio_num_t pwm_a_pin,
                     ledc_channel_t pwm_a_chan,
                     gpio_num_t pwm_b_pin,
                     ledc_channel_t pwm_b_chan,
                     gpio_num_t encoder_pin_a,
                     gpio_num_t encoder_pin_b,
                     bool reversed)
{
    // PWM
    configure_pwm(pwm_a_chan, pwm_a_pin);
    configure_pwm(pwm_b_chan, pwm_b_pin);

    motor->chan_a = pwm_a_chan;
    motor->chan_b = pwm_b_chan;

    motor->reversed = reversed;

    // ENCODER
    pcnt_unit_config_t unit_config = { .low_limit = INT16_MIN,
                                       .high_limit = INT16_MAX,
                                       .flags = { .accum_count = 1 } };

    ESP_ERROR_CHECK(pcnt_new_unit(&unit_config, &motor->encoder.unit));

    pcnt_glitch_filter_config_t filter_config = { .max_glitch_ns = 1000 };
    ESP_ERROR_CHECK(
      pcnt_unit_set_glitch_filter(motor->encoder.unit, &filter_config));

    pcnt_chan_config_t chan_config_a = { .edge_gpio_num = encoder_pin_a,
                                         .level_gpio_num = encoder_pin_b };
    ESP_ERROR_CHECK(pcnt_new_channel(
      motor->encoder.unit, &chan_config_a, &motor->encoder.channel_a));

    pcnt_chan_config_t chan_config_b = { .edge_gpio_num = encoder_pin_b,
                                         .level_gpio_num = encoder_pin_a };
    ESP_ERROR_CHECK(pcnt_new_channel(
      motor->encoder.unit, &chan_config_b, &motor->encoder.channel_b));

    ESP_ERROR_CHECK(
      pcnt_channel_set_edge_action(motor->encoder.channel_a,
                                   PCNT_CHANNEL_EDGE_ACTION_DECREASE,
                                   PCNT_CHANNEL_EDGE_ACTION_INCREASE));
    ESP_ERROR_CHECK(
      pcnt_channel_set_level_action(motor->encoder.channel_a,
                                    PCNT_CHANNEL_LEVEL_ACTION_KEEP,
                                    PCNT_CHANNEL_LEVEL_ACTION_INVERSE));
    ESP_ERROR_CHECK(
      pcnt_channel_set_edge_action(motor->encoder.channel_b,
                                   PCNT_CHANNEL_EDGE_ACTION_INCREASE,
                                   PCNT_CHANNEL_EDGE_ACTION_DECREASE));
    ESP_ERROR_CHECK(
      pcnt_channel_set_level_action(motor->encoder.channel_b,
                                    PCNT_CHANNEL_LEVEL_ACTION_KEEP,
                                    PCNT_CHANNEL_LEVEL_ACTION_INVERSE));

    ESP_ERROR_CHECK(pcnt_unit_add_watch_point(motor->encoder.unit, INT16_MAX));
    ESP_ERROR_CHECK(pcnt_unit_add_watch_point(motor->encoder.unit, INT16_MIN));

    ESP_ERROR_CHECK(pcnt_unit_enable(motor->encoder.unit));
    ESP_ERROR_CHECK(pcnt_unit_clear_count(motor->encoder.unit));
    ESP_ERROR_CHECK(pcnt_unit_start(motor->encoder.unit));

    // PID
    pid_ctrl_parameter_t pid_runtime_param = {
        .kp = 0.3, // TODO: tune these (maybe make them uROS controlled?)
        .ki = 0.3,
        .kd = 0.0,
        .cal_type = PID_CAL_TYPE_POSITIONAL,
        .max_output = 1.0,
        .min_output = -1.0,
        .max_integral = 0.3,
        .min_integral = -0.3,
    };
    pid_ctrl_block_handle_t pid_ctrl = NULL;
    pid_ctrl_config_t pid_config = {
        .init_param = pid_runtime_param,
    };
    ESP_ERROR_CHECK(pid_new_control_block(&pid_config, &pid_ctrl));
    motor->pid_controller = pid_ctrl;

    motor->pid_args = (esp_timer_create_args_t){ .callback = pid_callback,
                                                 .arg = motor,
                                                 .name = motor_name };
    motor->pid_timer = NULL;
    ESP_ERROR_CHECK(esp_timer_create(&motor->pid_args, &motor->pid_timer));
    esp_timer_start_periodic(motor->pid_timer, PID_LOOP_PERIOD_MS * 1000);
}

void init_motor_pwm()
{
    ledc_timer_config_t pwm_timer = { .speed_mode = LEDC_LOW_SPEED_MODE,
                                      .duty_resolution = PWM_TIMER_RESOLUTION,
                                      .timer_num = LEDC_TIMER_0,
                                      .freq_hz = PWM_FREQ_HZ,
                                      .clk_cfg = LEDC_AUTO_CLK };

    ESP_ERROR_CHECK(ledc_timer_config(&pwm_timer));
}
