little-red-rover/little-red-rover/SOFTWARE/esp32_firmware/components/LSM6DS3_imu_driver/include/LSM6DS3_imu_driver.h

#pragma once

#define LSM6DS3_ADDRESS 0b1101011

#define LSM6DS3_WHO_AM_I_REG 0X0F
#define LSM6DS3_CTRL1_XL 0X10
#define LSM6DS3_CTRL2_G 0X11

#define LSM6DS3_STATUS_REG 0X1E

#define LSM6DS3_CTRL6_C 0X15
#define LSM6DS3_CTRL7_G 0X16
#define LSM6DS3_CTRL8_XL 0X17

#define LSM6DS3_OUTX_L_G 0X22
#define LSM6DS3_OUTX_H_G 0X23
#define LSM6DS3_OUTY_L_G 0X24
#define LSM6DS3_OUTY_H_G 0X25
#define LSM6DS3_OUTZ_L_G 0X26
#define LSM6DS3_OUTZ_H_G 0X27

#define LSM6DS3_OUTX_L_XL 0X28
#define LSM6DS3_OUTX_H_XL 0X29
#define LSM6DS3_OUTY_L_XL 0X2A
#define LSM6DS3_OUTY_H_XL 0X2B
#define LSM6DS3_OUTZ_L_XL 0X2C
#define LSM6DS3_OUTZ_H_XL 0X2D

void LSM6DS3_imu_driver_init();
