little-red-rover/little-red-rover/(commit log)

2024-04-11 Add webserver for provisioning
    [partition_table.csv]
2024-04-18 Add ip detection script, add automatic uros client reconnect
    [partition_table.csv]
2024-04-19 Add lidar driver
2024-04-20 Working lidar in foxglove
2024-04-21 Initial PCB schematic
    [little_red_rover.kicad_pcb, little_red_rover.kicad_sch]
2024-04-21 v1.0 board layout
    [little_red_rover-B_Cu.gbr, little_red_rover-B_Mask.gbr, little_red_rover-B_Paste.gbr, little_red_rover-B_Silkscreen.gbr, little_red_rover-Edge_Cuts.gbr, little_red_rover-F_Cu.gbr, little_red_rover-F_Mask.gbr, little_red_rover-F_Paste.gbr]
2024-04-24 Update pcb outline, add threaded inserts
    [little_red_rover.kicad_pcb, little_red_rover.kicad_sch]
2024-04-24 Layout fixes + added QR code
    [little_red_rover.kicad_pcb, little_red_rover.kicad_sch]
2024-04-24 Add hardware README
    [little_red_rover.kicad_pcb]
2024-04-24 Change 5v boost converter due to shortage
    [little_red_rover-B_Cu.gbr, little_red_rover-B_Mask.gbr, little_red_rover-B_Paste.gbr, little_red_rover-B_Silkscreen.gbr, little_red_rover-Edge_Cuts.gbr, little_red_rover-F_Cu.gbr, little_red_rover-F_Mask.gbr, little_red_rover-F_Paste.gbr]
2024-04-25 V1.0 PCB ordered
2024-04-26 Fix threaded inserts not being included in BOM / placement
    [little_red_rover-B_Cu.gbr, little_red_rover-B_Mask.gbr, little_red_rover-B_Paste.gbr, little_red_rover-B_Silkscreen.gbr, little_red_rover-Edge_Cuts.gbr, little_red_rover-F_Cu.gbr, little_red_rover-F_Mask.gbr, little_red_rover-F_Paste.gbr]
2024-04-27 Fix hardfault when microcontroller resets while connected to agent
    [lidar_driver.c]
2024-05-02 Add rover urdf
    [lidar_motor.stl, lidar_top.stl, motor_mount_shim.stl, pcb.stl, robot.urdf, robot_body_visual.stl, skid.stl, tt_motor_3777_v10.stl]
2024-05-02 URDF loading working
    [robot.urdf, robot_body_visual.stl, wheel_2_visual.stl, wheel_visual.stl]
2024-05-02 Add frame_id to lidar scan
2024-06-14 Add drive base driver
2024-06-14 Add initial IMU driver
2024-06-19 Add i2c helpers
2024-06-20 Rewrite i2c functions using new syntax
2024-06-20 Update schematic: use ESP32-S3 mini, unflip usb lines, fix charger CE polarity, add header pins for GPIO, add buttons for strapping pins
    [little_red_rover.kicad_sch]
2024-06-20 Update PCB layout: Position components for new schematic updates
    [little_red_rover.kicad_pcb, little_red_rover.kicad_sch]
2024-06-24 Route traces for v1.1
    [little_red_rover.kicad_pcb, little_red_rover.kicad_sch]
2024-06-25 Add front and back silkscreen
2024-06-28 IMU WORKS RAHHHHHH
2024-06-28 Wheel encoders tested
2024-06-28 Remove pull ups on photointerupters
    [little_red_rover.kicad_sch]
2024-07-01 v1.1 ordered
    [little_red_rover-B_Cu.gbr, little_red_rover-B_Mask.gbr, little_red_rover-B_Paste.gbr, little_red_rover-Edge_Cuts.gbr, little_red_rover-F_Cu.gbr, little_red_rover-F_Mask.gbr, little_red_rover-F_Paste.gbr, little_red_rover-F_Silkscreen.gbr]
2024-07-08 Refactor ros2 workspace dockerfile, add black formatter
    [testing.sdf]
2024-07-11 Switch to esp32s3
    [testing.sdf]
2024-07-11 Fix network bugs that were causing s3 to boot loop
    [lidar_driver.c]
2024-07-11 Tie charger TD low to enable charge termination
    [little_red_rover.kicad_sch]
2024-07-14 Add encoder driver, teleop working
2024-07-16 Added controller support
    [encoder_ring.stl, lidar_motor.stl, lidar_top.stl, little_red_rover.kicad_sch, lrr.urdf.xacro, lrr_controllers.yaml, motor_mount_shim.stl, pcb.stl]
2024-07-20 Regenerated urdf from onshape model
    [coordinate_frame.stl, robot.urdf, robot_body_visual.stl, wheel_left.stl, wheel_left_visual.stl, wheel_right.stl, wheel_right_visual.stl]
2024-07-20 Fix crash related to rapid reconnects to microros agent
    [lidar_driver.c]
2024-07-20 Update robot URDF from onshape
    [robot.urdf, robot_body_visual.stl, wheel_left_visual.stl, wheel_right_visual.stl]
2024-07-20 Invert lidar frame, fix agent disconnect causing a crash
    [robot.urdf, robot_body_visual.stl, wheel_left_visual.stl, wheel_right_visual.stl]
2024-07-22 Move motor driver into seperate file, add PID control
2024-07-22 PID control
    [pcb.stl, robot.urdf, robot_body_visual.stl, skid.stl, wheel_left_visual.stl, wheel_right_visual.stl]
2024-07-23 Update schematic: reverse polarity protection, JST motor connectors, power switch
    [little_red_rover.kicad_sch]
2024-07-23 Update layout: route schematic changes
    [little_red_rover.kicad_sch]
2024-07-24 Update layout: Correct transistor pin numbers, replace hand solder esp footprint.
    [little_red_rover.kicad_sch]
2024-07-24 Update layout: Update front silkscreen, adopt semver.
2024-07-25 PCB ordered, v 0.2.0
    [little_red_rover-B_Cu.gbr, little_red_rover-B_Mask.gbr, little_red_rover-B_Paste.gbr, little_red_rover-Edge_Cuts.gbr, little_red_rover-F_Cu.gbr, little_red_rover-F_Mask.gbr, little_red_rover-F_Paste.gbr, little_red_rover-F_Silkscreen.gbr]
2024-07-26 Update encoder driver for quadrature
2024-07-27 Update PID weights for quadrature encoders
2024-07-27 Add hysteresis to motor commands
2024-07-28 Change battery IC for a higher current version, change motors to be powered straight from charger output rather than 5v regulation.
    [little_red_rover.kicad_sch]
2024-07-29 PCB ordered, v 0.2.1
    [little_red_rover-B_Cu.gbr, little_red_rover-B_Mask.gbr, little_red_rover-B_Paste.gbr, little_red_rover-Edge_Cuts.gbr, little_red_rover-F_Cu.gbr, little_red_rover-F_Mask.gbr, little_red_rover-F_Paste.gbr, little_red_rover-F_Silkscreen.gbr]
2024-07-29 Fix current limiting for wheel motors
    [drive_base_driver.c, lidar_driver.c, motor_driver.c, motor_driver.h]
2024-08-04 Move foxglove bridge into ros2_workspace docker image, remove urdf server
    [lidar_motor.stl, lidar_top.stl, motor_attachment_shim.stl, motor_mount_shim.stl, pcb.stl, robot.urdf, robot_body_visual.stl, skid.stl]
2024-08-12 Update robot description for proper wheel directions
    [robot.urdf, robot_body_visual.stl, wheel_left_visual.stl, wheel_right_visual.stl]
2024-08-12 Fixes for agent reconnect
    [drive_base_driver.c, lidar_driver.c, motor_driver.c, motor_driver.h]
2024-08-12 sdkconfig settings to improve high volume udp throughput with lidar messages
2024-08-12 Add odom_publisher node, fix deserialization bug
    [drive_base_driver.c, lidar_driver.c]
2024-08-13 Increase MTU to prevent deserialization errors
    [drive_base_driver.c]
2024-08-15 Add socket manager
2024-08-16 Lidar send / recieve working
2024-08-16 Laser, wheel states, cmd_vel over sockets implemented
2024-08-16 Wheel encoder only localization working
    [robot.urdf, robot_body_visual.stl, wheel_left_visual.stl, wheel_right_visual.stl]
2024-08-19 Batch laser messages into single packet for better network performance
2024-08-25 Ordered PCB v0.2.2: FA '24 beta test
    [little_red_rover-B_Cu.gbr, little_red_rover-B_Mask.gbr, little_red_rover-B_Paste.gbr, little_red_rover-Edge_Cuts.gbr, little_red_rover-F_Cu.gbr, little_red_rover-F_Mask.gbr, little_red_rover-F_Paste.gbr, little_red_rover-F_Silkscreen.gbr]
2024-08-25 Update URDF to match CAD
    [lrr_controllers.yaml, robot.urdf, robot_body_visual.stl, wheel_left_visual.stl, wheel_right_visual.stl]
2024-08-25 Add status led driver
